mstrouthos/voron-shuttlechanger/step/01_CW2_main_body.step

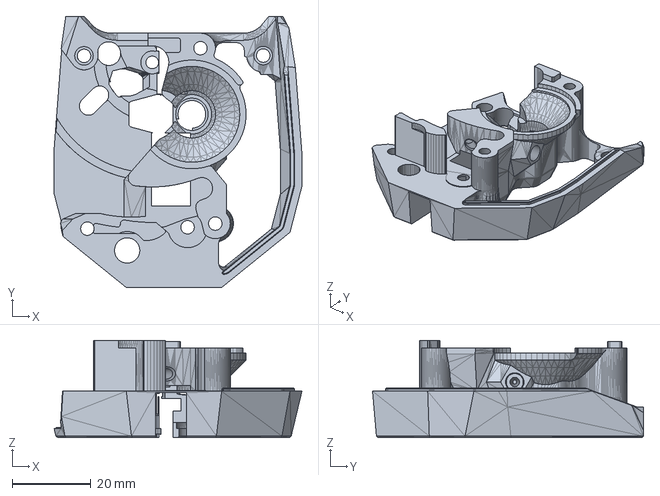
[picture p6: CAD file, 2026-11-10]
step/01_CW2_main_body.step
62.8 x 68.7 x 24.7 mm
