mstrouthos/voron-shuttlechanger/step/03_opener_trunnion.step

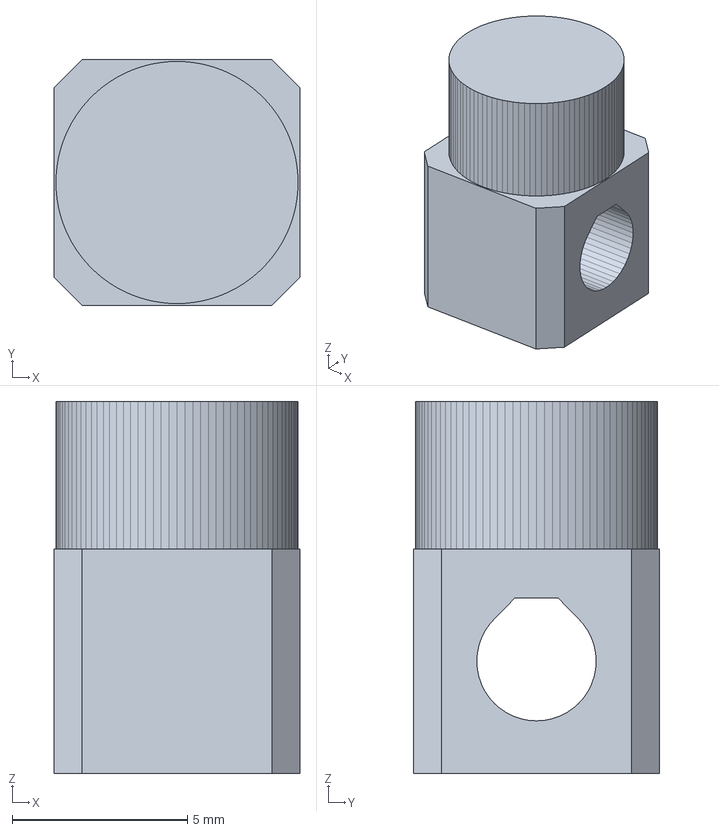
[picture p7: CAD file, 2026-11-11]
step/03_opener_trunnion.step
7.00 x 7.00 x 10.6 mm
