mstrouthos/voron-shuttlechanger/step/04_opener_servo_crank.step

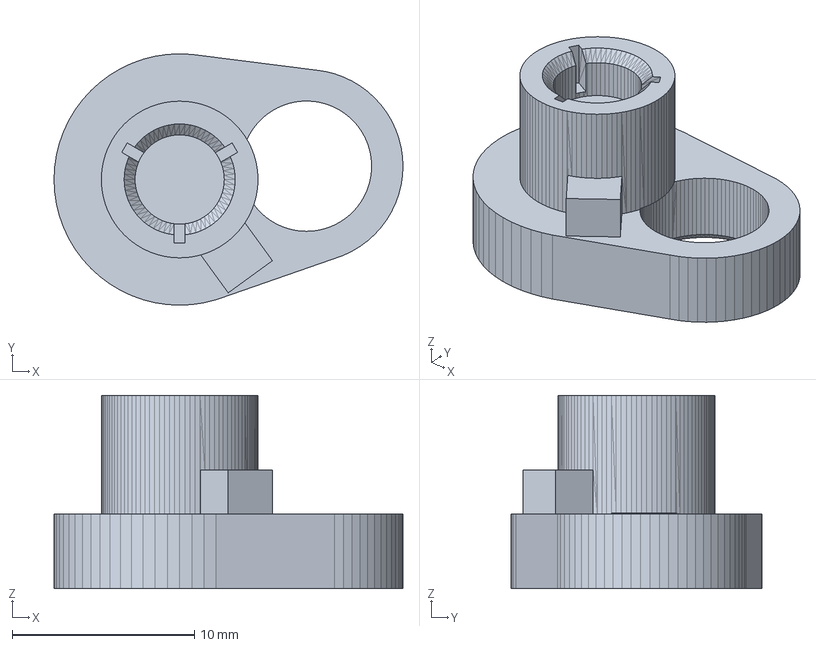
[picture p8: CAD file, 2026-11-11]
step/04_opener_servo_crank.step
19.2 x 13.8 x 10.6 mm
