mstrouthos/voron-shuttlechanger/step/10_tool_top_x_each_tool.step

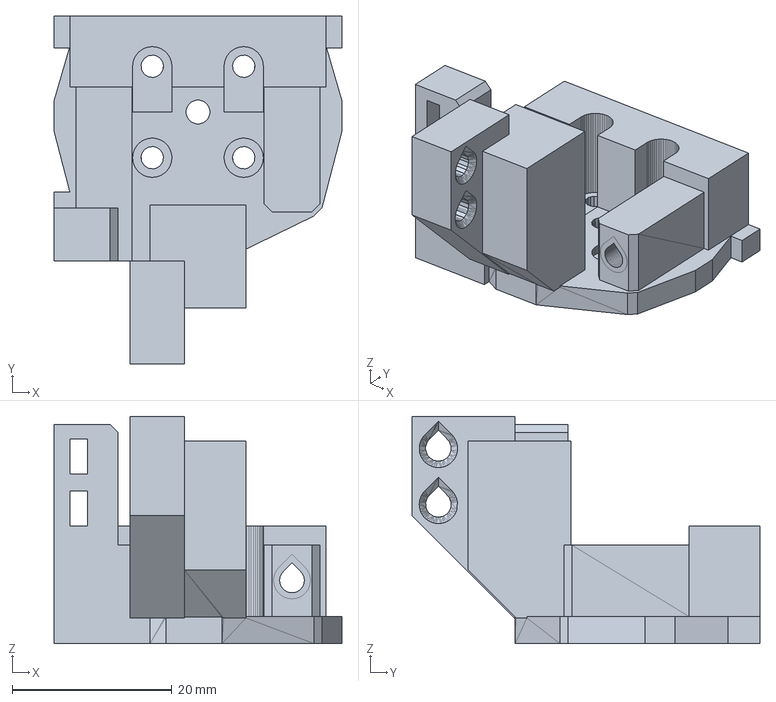
[picture p9: CAD file, 2026-11-11]
step/10_tool_top_x_each_tool.step
36.0 x 43.5 x 28.4 mm
