mstrouthos/voron-shuttlechanger/step/07_receiver_pins_magnets.step

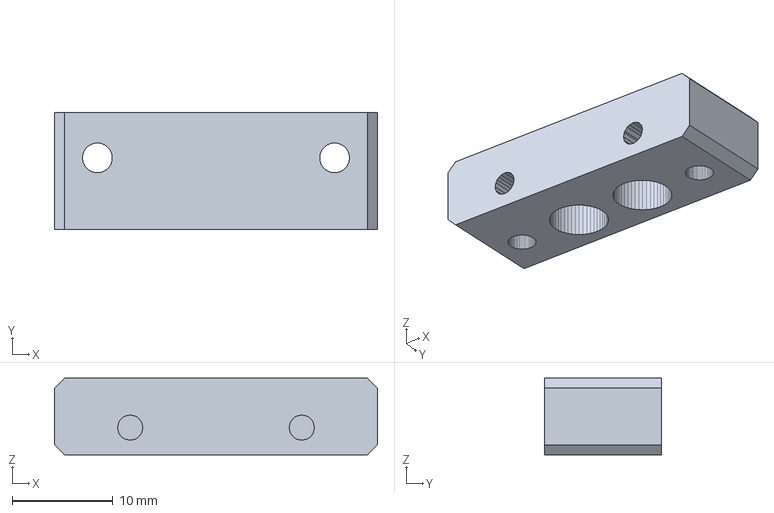
[picture p10: CAD file, 2026-11-11]
step/07_receiver_pins_magnets.step
32.0 x 11.6 x 7.60 mm
