mstrouthos/voron-shuttlechanger/step/12_tool_shroud_4010_DragonHF.step

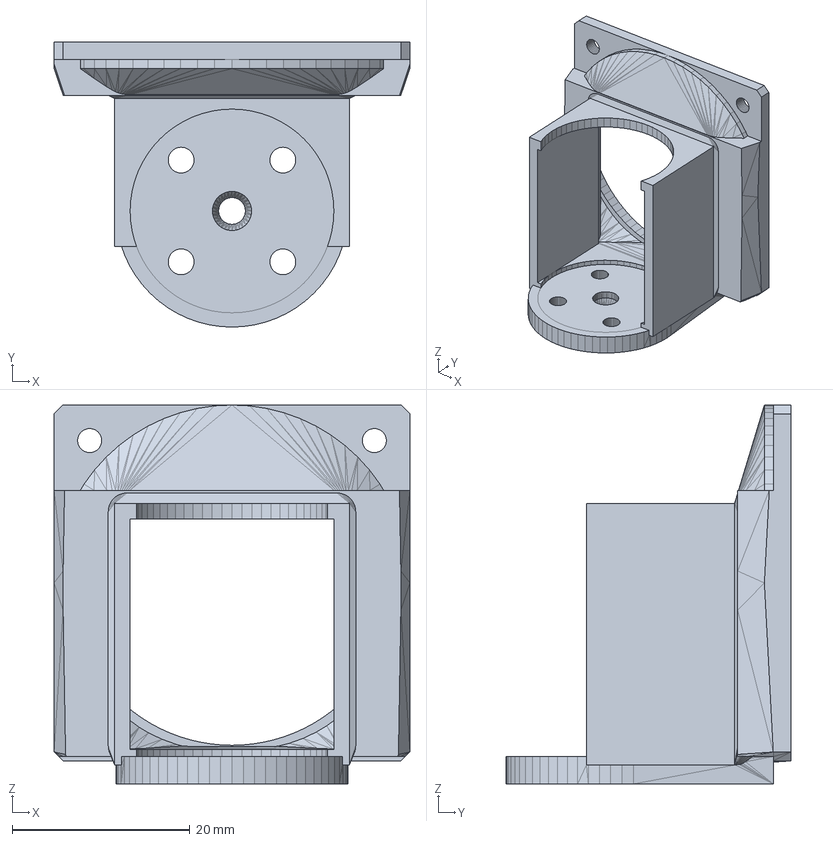
[picture p11: CAD file, 2026-11-10]
step/12_tool_shroud_4010_DragonHF.step
40.0 x 32.0 x 42.6 mm
