mstrouthos/voron-shuttlechanger/step/05_CW2_motor_plate_opener.step

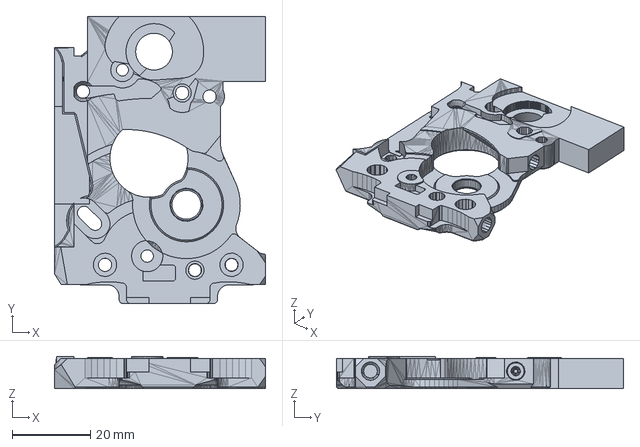
[picture p12: CAD file, 2026-11-10]
step/05_CW2_motor_plate_opener.step
54.1 x 73.5 x 8.32 mm
