mstrouthos/voron-shuttlechanger/step/11_tool_shroud_4010_TZ-V6.step

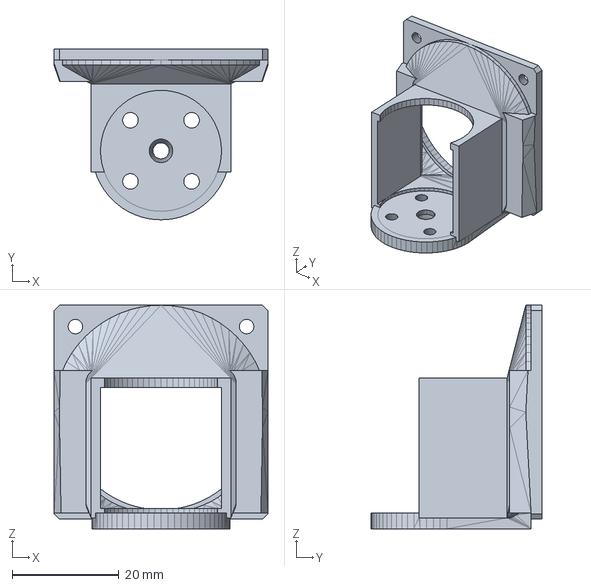
[picture p13: CAD file, 2026-11-10]
step/11_tool_shroud_4010_TZ-V6.step
40.0 x 31.9 x 41.8 mm
