mstrouthos/voron-shuttlechanger/step/09_duct_and_fan_mount.step

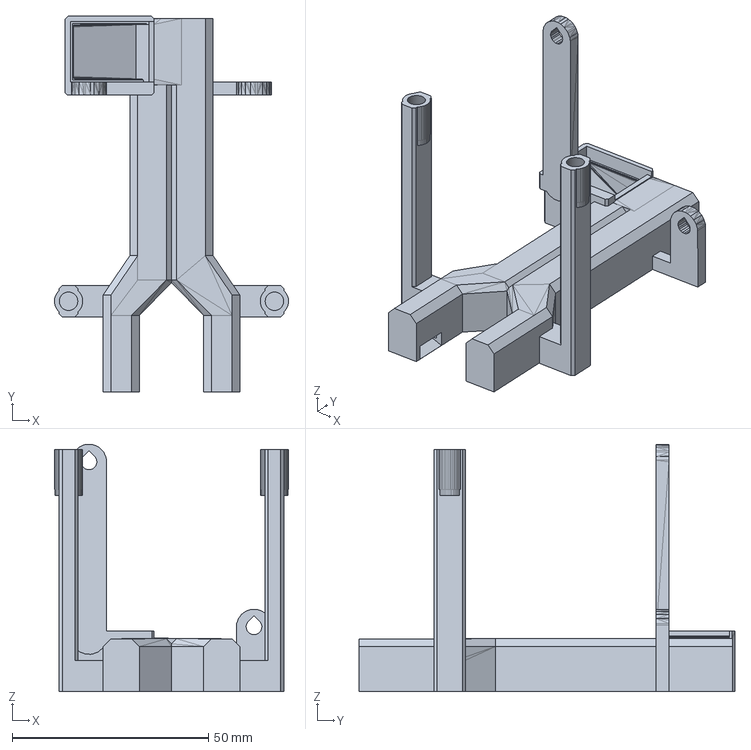
[picture p14: CAD file, 2026-11-10]
step/09_duct_and_fan_mount.step
59.6 x 95.7 x 63.0 mm
