mstrouthos/voron-shuttlechanger/step/02b_CW2_guidler_B_stock.step

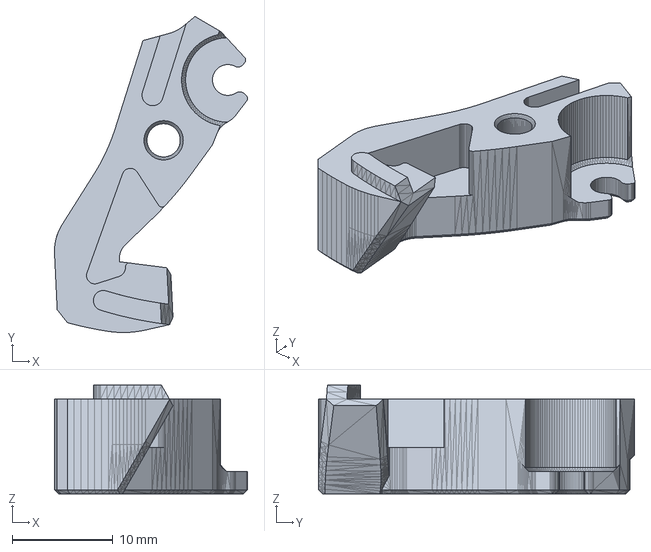
[picture p15: CAD file, 2026-11-10]
step/02b_CW2_guidler_B_stock.step
19.2 x 31.4 x 10.8 mm
