mstrouthos/voron-shuttlechanger/step/08_receiver_frame.step

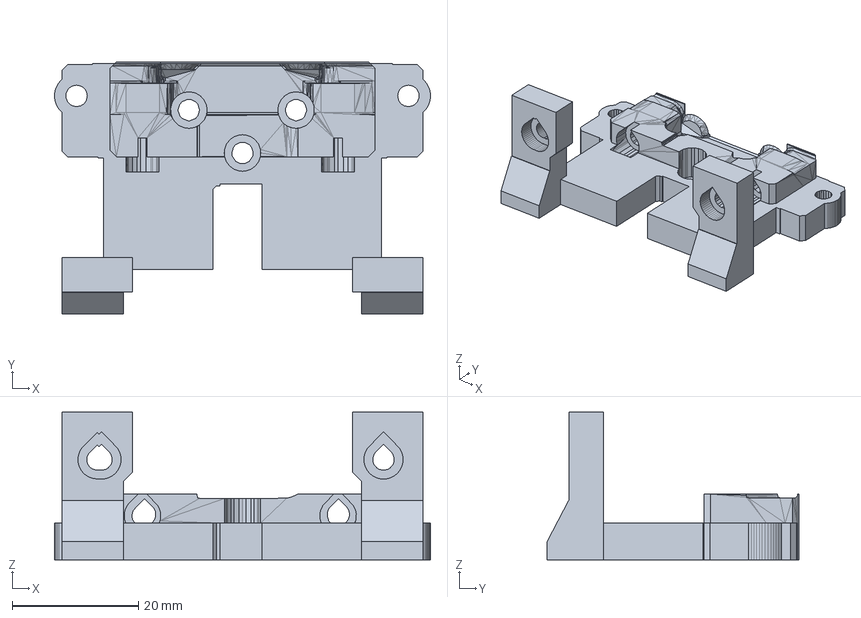
[picture p16: CAD file, 2026-11-10]
step/08_receiver_frame.step
59.6 x 39.9 x 23.4 mm
