mstrouthos/voron-shuttlechanger/step/02_CW2_guidler_A_mast.step

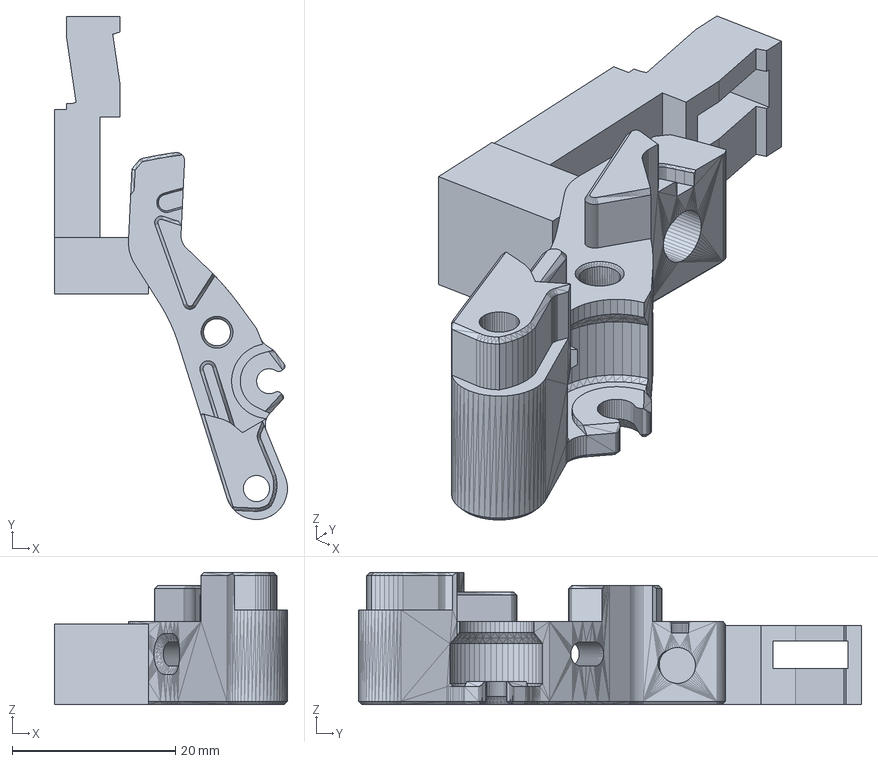
[picture p17: CAD file, 2026-11-09]
step/02_CW2_guidler_A_mast.step
28.5 x 61.6 x 16.2 mm
