mstrouthos/voron-shuttlechanger/step/06_servo_bracket.step

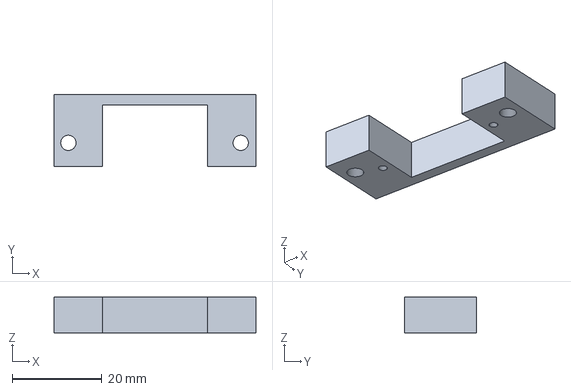
[picture p18: CAD file, 2026-11-09]
step/06_servo_bracket.step
45.0 x 16.1 x 8.00 mm
