mstrouthos/voron-shuttlechanger/step/13_dock_x_each_tool.step

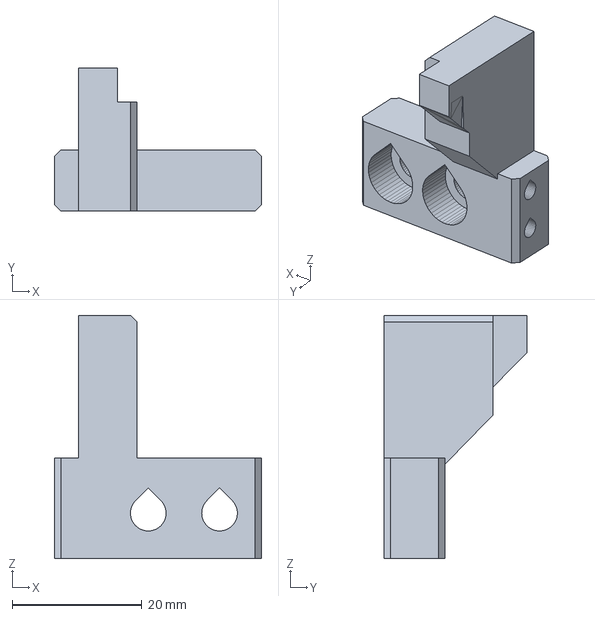
[picture p19: CAD file, 2026-11-09]
step/13_dock_x_each_tool.step
32.0 x 22.1 x 37.5 mm
