mstrouthos/voron-shuttlechanger/step/10b_tool_filament_guide_lever_x_each_tool.step

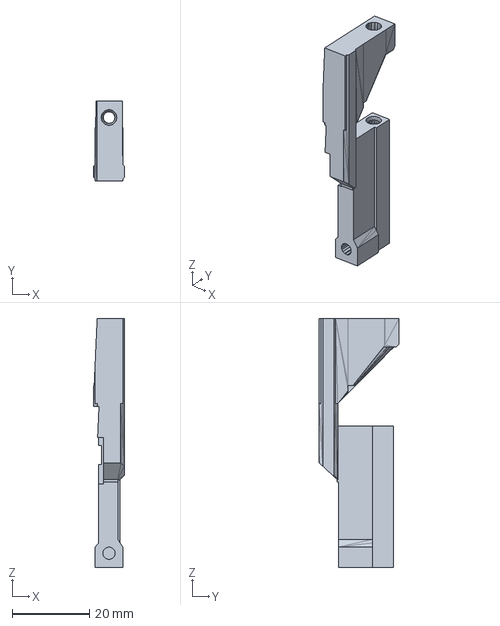
[picture p20: CAD file, 2026-11-09]
step/10b_tool_filament_guide_lever_x_each_tool.step
8.00 x 20.8 x 64.6 mm
