mstrouthos/voron-shuttlechanger/(list of files, cad)

Other CAD files:
stl/01_CW2_main_body.stl
stl/02_CW2_guidler_A_mast.stl
stl/02b_CW2_guidler_B_stock.stl
stl/03_opener_trunnion.stl
stl/04_opener_servo_crank.stl
stl/05_CW2_motor_plate_opener.stl
stl/06_servo_bracket.stl
stl/07_receiver_pins_magnets.stl
stl/08_receiver_frame.stl
stl/09_duct_and_fan_mount.stl
stl/10_tool_top_x_each_tool.stl
stl/10b_tool_filament_guide_lever_x_each_tool.stl
stl/11_tool_shroud_4010_TZ-V6.stl
stl/12_tool_shroud_4010_DragonHF.stl
stl/13_dock_x_each_tool.stl
