mstrouthos/voron-shuttlechanger/(commit log)

2026-11-09 Shuttlechanger v29: STL, STEP, BOM, viewer, audits and README
    Claude-Session: https://claude.ai/code/session_01GVdDNxjEKqWd7ByWRZx4H9
    [01_CW2_main_body.step, 01_CW2_main_body.stl, 02_CW2_guidler_A_arm_hole_4.4.step, 02_CW2_guidler_A_arm_hole_4.4.stl, 03_opener_spring_shuttle.step, 03_opener_spring_shuttle.stl, 04_opener_servo_crank.step, 04_opener_servo_crank.stl]
2026-11-09 Shuttlechanger v30: servo crank and pull-rod opener
    Replace the v29 spring shuttle and rail with a compact opener:
    - servo lies flat behind the motor plate above the LDO-36 and turns a
    crank in the gap between the CW2 body and the plate
    - a trunnion on the crank works an M3x55 pull rod from a new mast on
    Guidler A to the stock spring and a tension nyloc
    - crank locks 6 deg over centre when closed; 166 deg travel opens the
    idler 11.4 deg; peak load about 25 N mm
    - head is about 17 mm narrower on the left (1.9 mm past the body
    closed, 12.2 mm open); plate top +2.7 mm
    Parts 02-06 updated (03 trunnion is new), old 02/03/05 files removed.
    Viewer, images, BOM, assembly notes and audits up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
    [02_CW2_guidler_A_arm_hole_4.4.step, 02_CW2_guidler_A_arm_hole_4.4.stl, 02_CW2_guidler_A_mast.step, 02_CW2_guidler_A_mast.stl, 03_opener_spring_shuttle.step, 03_opener_spring_shuttle.stl, 03_opener_trunnion.step, 03_opener_trunnion.stl]
2026-11-10 Shuttlechanger v30.1: mounting holes, trunnion retention, spline fit
    - CW2 body: open Ø3.4 front holes into both insert pockets for the
    receiver-frame post screws; full Ø4.7 right pocket with a boss
    - receiver frame: left post hole lined up with its insert, Tap screw
    holes opened to Ø3.5
    - trunnion held in the crank by an M2x3 button head + washer through a
    Ø4 spigot; crank 1.5 mm thicker in a matching plate recess
    - crank spline socket Ø4.6 -> Ø4.75 with three relief slits
    - viewer, images, BOM, assembly notes and audits updated
    [01_CW2_main_body.step, 01_CW2_main_body.stl, 03_opener_trunnion.step, 03_opener_trunnion.stl, 04_opener_servo_crank.step, 04_opener_servo_crank.stl, 05_CW2_motor_plate_opener.step, 05_CW2_motor_plate_opener.stl]
2026-11-10 Add stock CW2 Guidler B (02b) to the printed parts
    The head uses the stock Clockwork 2 Guidler B unmodified. Its STL is the
    CW2 version from the Voron Stealthburner release (GPL-3.0), with a STEP
    conversion, BOM/README rows, viewer BOM row and audit entries.
    [02b_CW2_guidler_B_stock.step, 02b_CW2_guidler_B_stock.stl, BOM.csv]
2026-11-10 Shuttlechanger v30.2: illustrated assembly guide, SB2209 setup, insert holes
    - docs/ASSEMBLY_GUIDE.md: step-by-step build with exploded illustrations
    of every insert, magnet and dowel (stock CW2 inserts included, sizes
    labelled), the opener sub-assemblies, SB2209 servo wiring and Klipper
    config/commissioning
    - images/assembly/: 11 renders from the part geometry + wiring diagram
    - one insert size everywhere: all 12 holes Ø4.7 for M3x5x4 (plate servo
    bracket and duct leg holes were Ø4.0); duct towers keep 1.2 mm walls;
    unused v29 plate insert hole filled
    - BOM, README, assembly notes, viewer and audits updated
    [05_CW2_motor_plate_opener.step, 05_CW2_motor_plate_opener.stl, 09_duct_and_fan_mount.step, 09_duct_and_fan_mount.stl, BOM.csv]
2026-11-10 Shuttlechanger v30.3: screw-path audit and hole fixes
    Traced all 34 screws through every printed part (audit/screw_audit.json).
    - motor plate: reopen three stock holes that v29 had closed with
    0.4-0.6 mm skins on the bed side (right LDO motor screw, lower front
    insert screw clearance, sealed back-face insert pocket), matching the
    original Voron plate; reliefs for the M3x6 receiver-screw heads that
    hit the plate edge by 1 mm; fill unused v29 dimple
    - shrouds 11/12: add the two missing upper 4010 fan-screw holes
    - viewer, plate illustrations, audits and docs updated
    [05_CW2_motor_plate_opener.step, 05_CW2_motor_plate_opener.stl, 11_tool_shroud_4010_TZ-V6.step, 11_tool_shroud_4010_TZ-V6.stl, 12_tool_shroud_4010_DragonHF.step, 12_tool_shroud_4010_DragonHF.stl]
2026-11-11 Shuttlechanger v30.4: complete assembly guide with exploded views
    Exploded views of the head and the tool with numbered parts tables, a full
    hardware list including the stock CW2 drivetrain and every screw size, and
    illustrated steps for the CW2 build, receiver/frame/duct, tools and docks.
    BOM now lists the stock CW2 hardware.
    [BOM.csv]
2026-11-11 Shuttlechanger v30.5: Ø3x30 tool locating pins instead of Ø4x30
    Receiver (07) press bores and tool-top (10) slip bores resized for Ø3
    hardened dowels, with a new lead-in chamfer on the tool top. Ø5 was
    rejected: the bores sit 3.5 mm from the side walls. Viewer, BOM, guides,
    audits and the affected illustrations updated.
    [07_receiver_pins_magnets.step, 07_receiver_pins_magnets.stl, 10_tool_top_x_each_tool.step, 10_tool_top_x_each_tool.stl, BOM.csv]
2026-11-11 Shuttlechanger v30.6: build the whole head on the bench, then mount it
    The plate-to-Tap M3x10s drop into the plate before the CW2 body and are
    tightened through the body's front holes with a 2.5 mm hex key, so the
    CW2, motor, servo, crank and pull rod are all assembled off the printer.
    Guide reordered: prepare parts, wire the servo, bench build, mount,
    tools and docks, setup. New and updated illustrations for these steps.
    [BOM.csv]
2026-11-11 Shuttlechanger v30.7: trunnion prints upright, looser crank hub
    - 03 trunnion now prints standing on its square end: the spigot, journal
    and M2 pilot print as vertical circles, the rod hole is a truncated
    teardrop. Bed contact 26 -> 48 mm2, steep overhang 29 -> 9 mm2.
    Journal Ø6.9 (was Ø7.0); chamfer cutters no longer leave slivers.
    - 04 crank hub Ø8.6 (was Ø9.0): 0.4 mm per side in the plate bore
    (was 0.2), so it turns freely. Relief slits 0.2 mm shorter.
    - Viewer meshes, STEP, audits and docs updated.
    [03_opener_trunnion.step, 03_opener_trunnion.stl, 04_opener_servo_crank.step, 04_opener_servo_crank.stl]
2026-11-11 Shuttlechanger v30.8: M3x4 button head holds the trunnion
    - 03 trunnion: spigot Ø4.8 with a Ø2.5 self-tapping pilot that opens
    into the rod hole; an M3x4 tip ends 0.4 mm above the pull rod.
    - 04 crank: web hole Ø4.95, counterbore Ø6.2. The Ø5.7 head overlaps
    the web and sits on the spigot end (0.1 mm proud), no washer needed.
    Head clears the plate recess by 0.35 mm over the whole travel.
    - BOM, guide, notes, viewer, audits and illustrations updated.
    [03_opener_trunnion.step, 03_opener_trunnion.stl, 04_opener_servo_crank.step, 04_opener_servo_crank.stl, BOM.csv]
2026-11-11 Shuttlechanger v30.9: bayonet twist-lock holds the trunnion
    The M3x4 self-tapping screw didn't grip in the thin spigot and the
    trunnion wobbled. It is now held by a bayonet; no hardware.
    - 03 trunnion: Ø4.8 spigot 2.7 mm long with 2 lugs (50°, to Ø6.0,
    1.25 thick) 120° apart, so it only releases at one angle. Screw
    pilot removed.
    - 04 crank: 2 matching 60° notches in the web, counterbore Ø6.4.
    Axial play 0.15 mm.
    - Insert at +106° relative to the crank; in service the trunnion only
    turns 0 to -148°, and the model shows it only comes free between
    +102° and +110°. Full-sweep collision check unchanged.
    - M3x4 removed from the BOM and viewer; guide step 3.9, notes, audits,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
    [03_opener_trunnion.step, 03_opener_trunnion.stl, 04_opener_servo_crank.step, 04_opener_servo_crank.stl, BOM.csv]
2026-11-11 Shuttlechanger v30.10: stronger trunnion bayonet, looser spline socket
    - 03 trunnion: lugs 70° wide, out to Ø6.9, 1.5 thick; 1.0 mm
    overlap on the crank web (was 0.5), so print tolerance can't let
    them slip past.
    - 04 crank: notches 80°, counterbore Ø7.4. Spline socket Ø4.75 ->
    Ø4.9 with a 0.6 lead-in chamfer; it was far too tight to push on.
    - Release window unchanged (+102..+110°); full-sweep collision check
    unchanged. Docs, audits, viewer and illustration updated.
    [03_opener_trunnion.step, 03_opener_trunnion.stl, 04_opener_servo_crank.step, 04_opener_servo_crank.stl]
2026-11-11 ASSEMBLY.md: fix a garbled sentence in the crank step
2026-11-11 Shuttlechanger v30.11: plain-boss trunnion joint, no screw or bayonet
    The screw and bayonet versions both needed tiny features (thin spigot,
    1 mm lugs, notches, stepped counterbores) that don't print reliably.
    - 03 trunnion: 7x7 block plus a plain Ø6.9 boss, 4.3 long, printed
    standing on the block. Nothing thin, no lugs, no pilot.
    - 04 crank: plain Ø7.15 through bore, 4.1 long, front lead-in.
    - Retention by the pull rod: the rod's tilt in the mast slot plus hole
    clearance allow at most 2.2 mm forward slide; 1.8 of the 4.0 mm boss
    stays engaged. The bearing is 3x longer, so it wobbles less.
    - Full-sweep collision and print checks pass; docs, audits, viewer and
    illustrations updated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
    [03_opener_trunnion.step, 03_opener_trunnion.stl, 04_opener_servo_crank.step, 04_opener_servo_crank.stl, BOM.csv]
